bryceehill/EE_DEV_Board_2023/README.md

# EE_DEV_Board_2023
Files and Documentation for the Montana Tech EE Development Board
