bryceehill/EE_DEV_Board_2023/LayoutScrambled.PNG

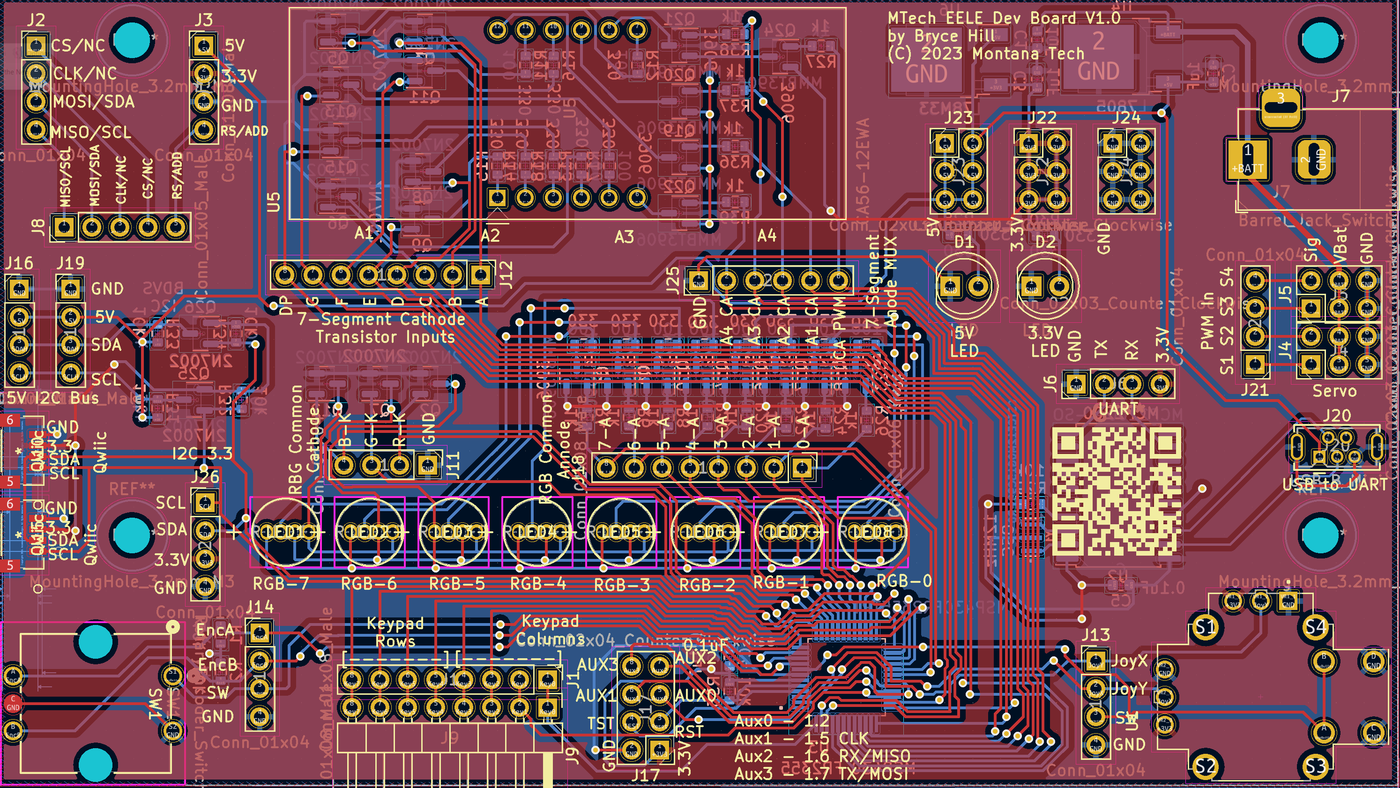
LayoutScrambled.PNG
