bryceehill/EE_DEV_Board_2023/LeftMCU.PNG

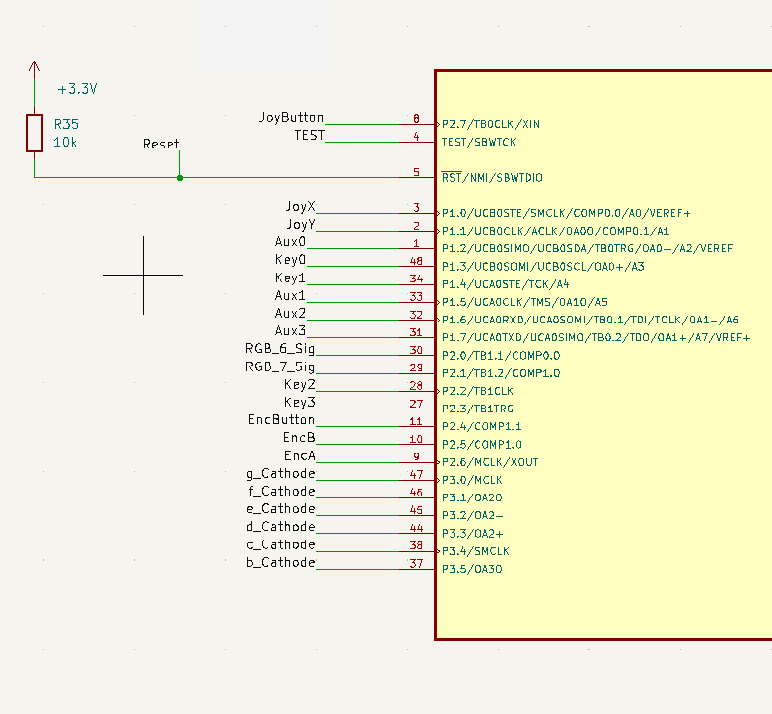
LeftMCU.PNG
