bryceehill/EE_DEV_Board_2023/RightMCU.PNG

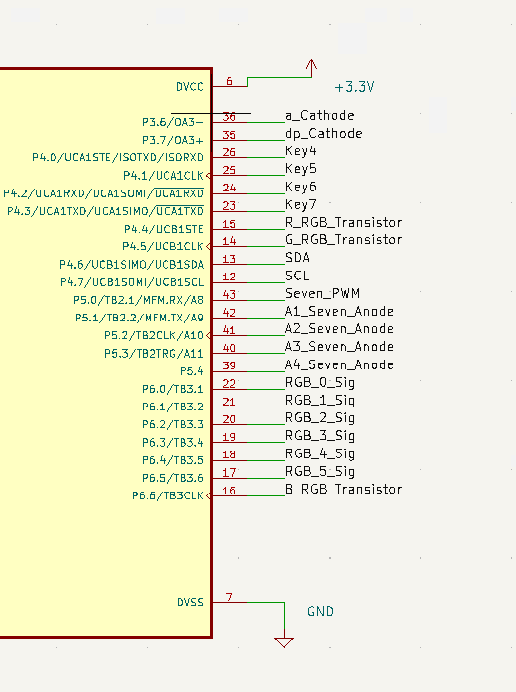
RightMCU.PNG
