bryceehill/EE_DEV_Board_2023/Schem_Dev2p0_Frame_2.PNG

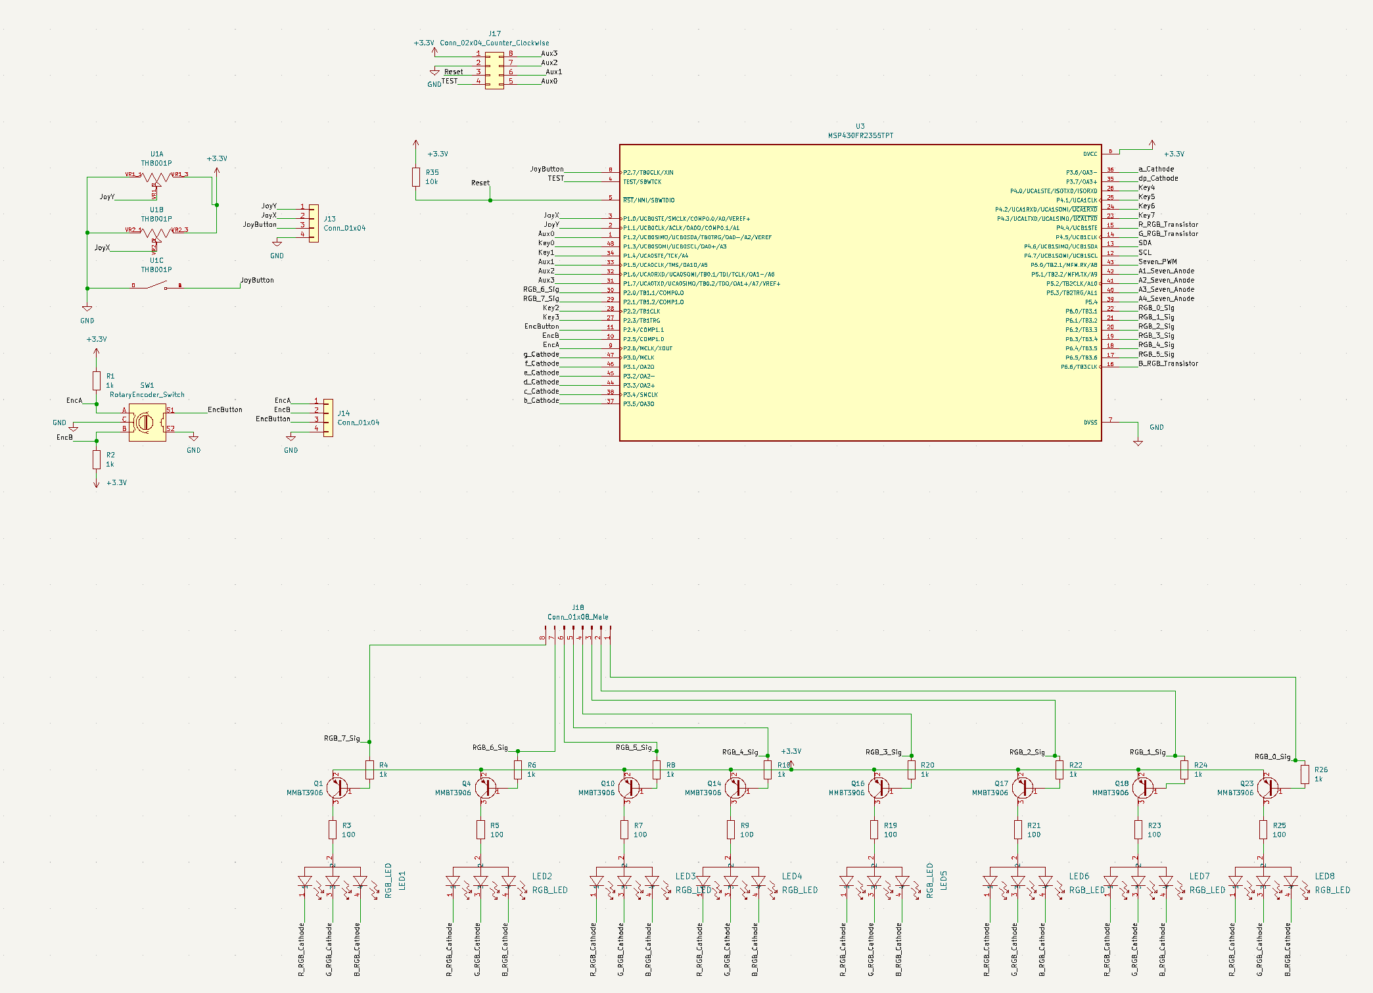
Schem_Dev2p0_Frame_2.PNG
