bryceehill/EE_DEV_Board_2023/DevBoard2.0.pdf

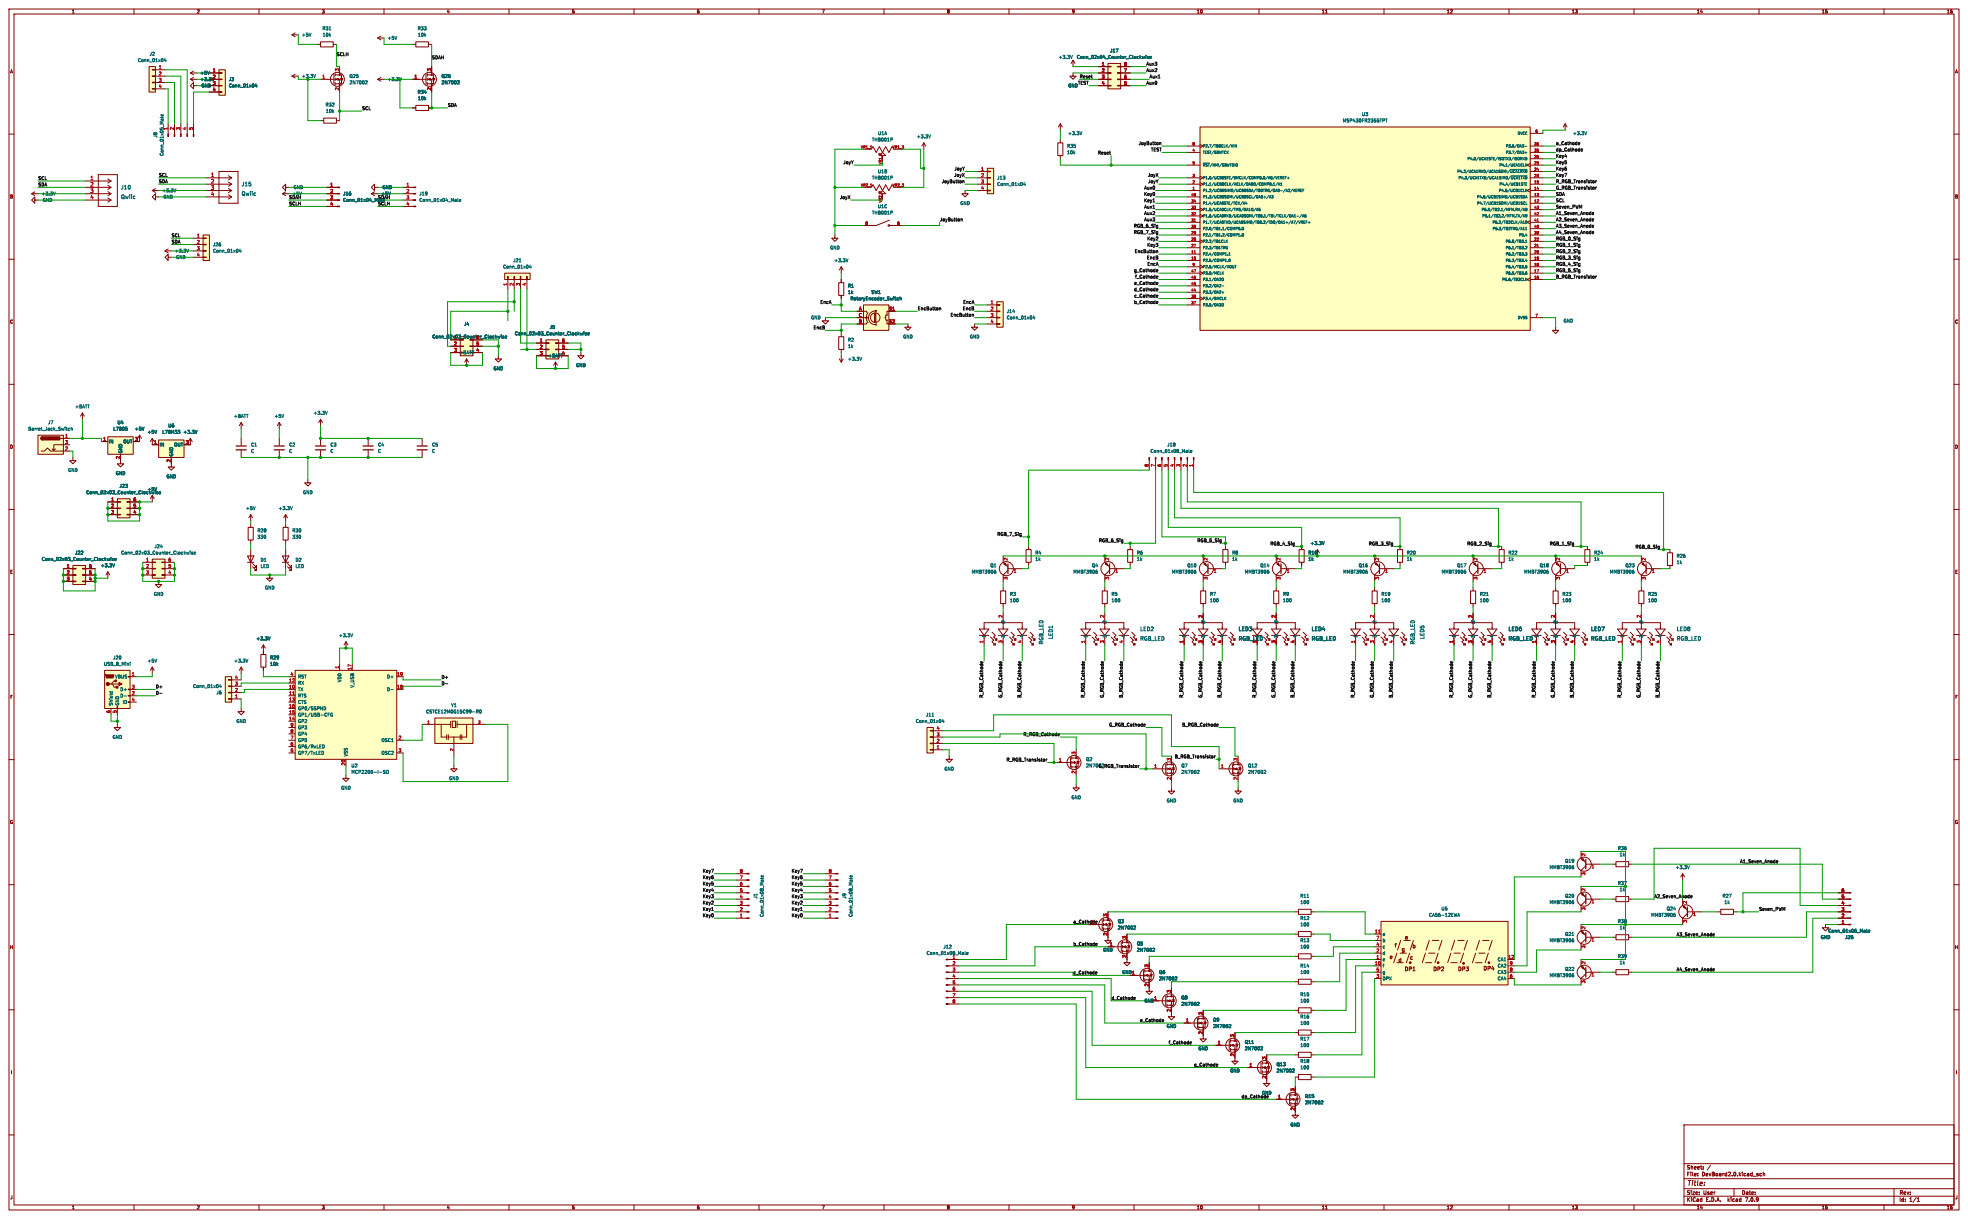
[picture p11: page 1]

1 TX 10 RTS 11 RX 12 CTS 13 GP2 14 GP1/USB-CFG 15 GP0/SSPND 16 V_USB 17 D- 18 D+ 19 OSC1 2 VSS 20 OSC2 3 RST 4 GP7/TxLED 5 GP6/RxLED 6 GP5 7 GP4 8 GP3 9 U2 MCP2200-I-SO
