bryceehill/EE_DEV_Board_2023/DevBoard2.0/DevBoard2.0.kicad_pcb

## KiCad design DevBoard2.0/DevBoard2.0.kicad_pcb (2023-08-30)

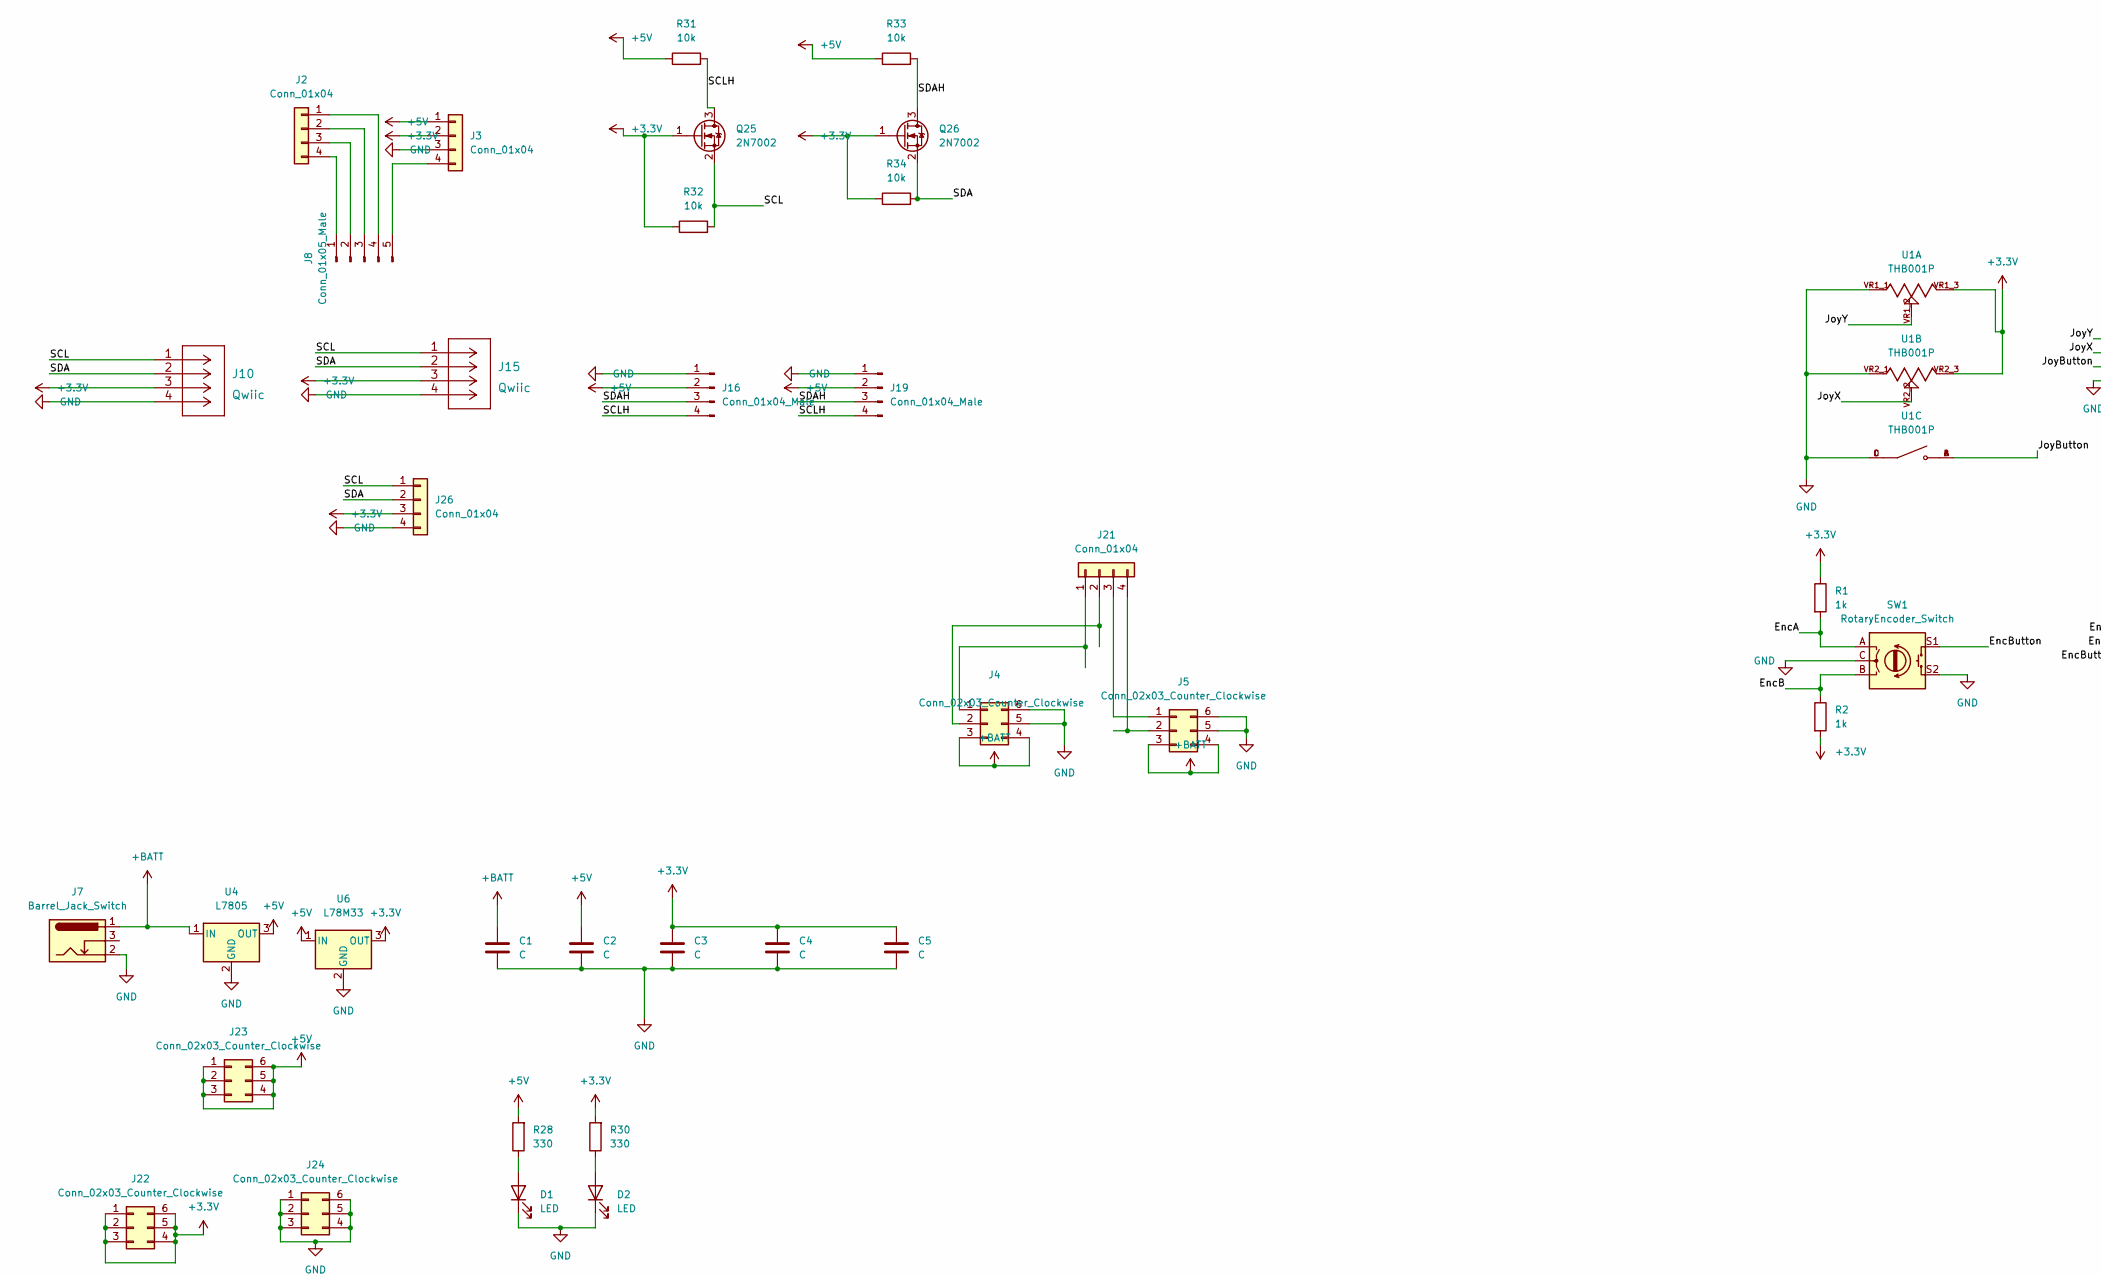
[picture p12: schematic DevBoard2.0.kicad_sch, part in row 1, column 1]

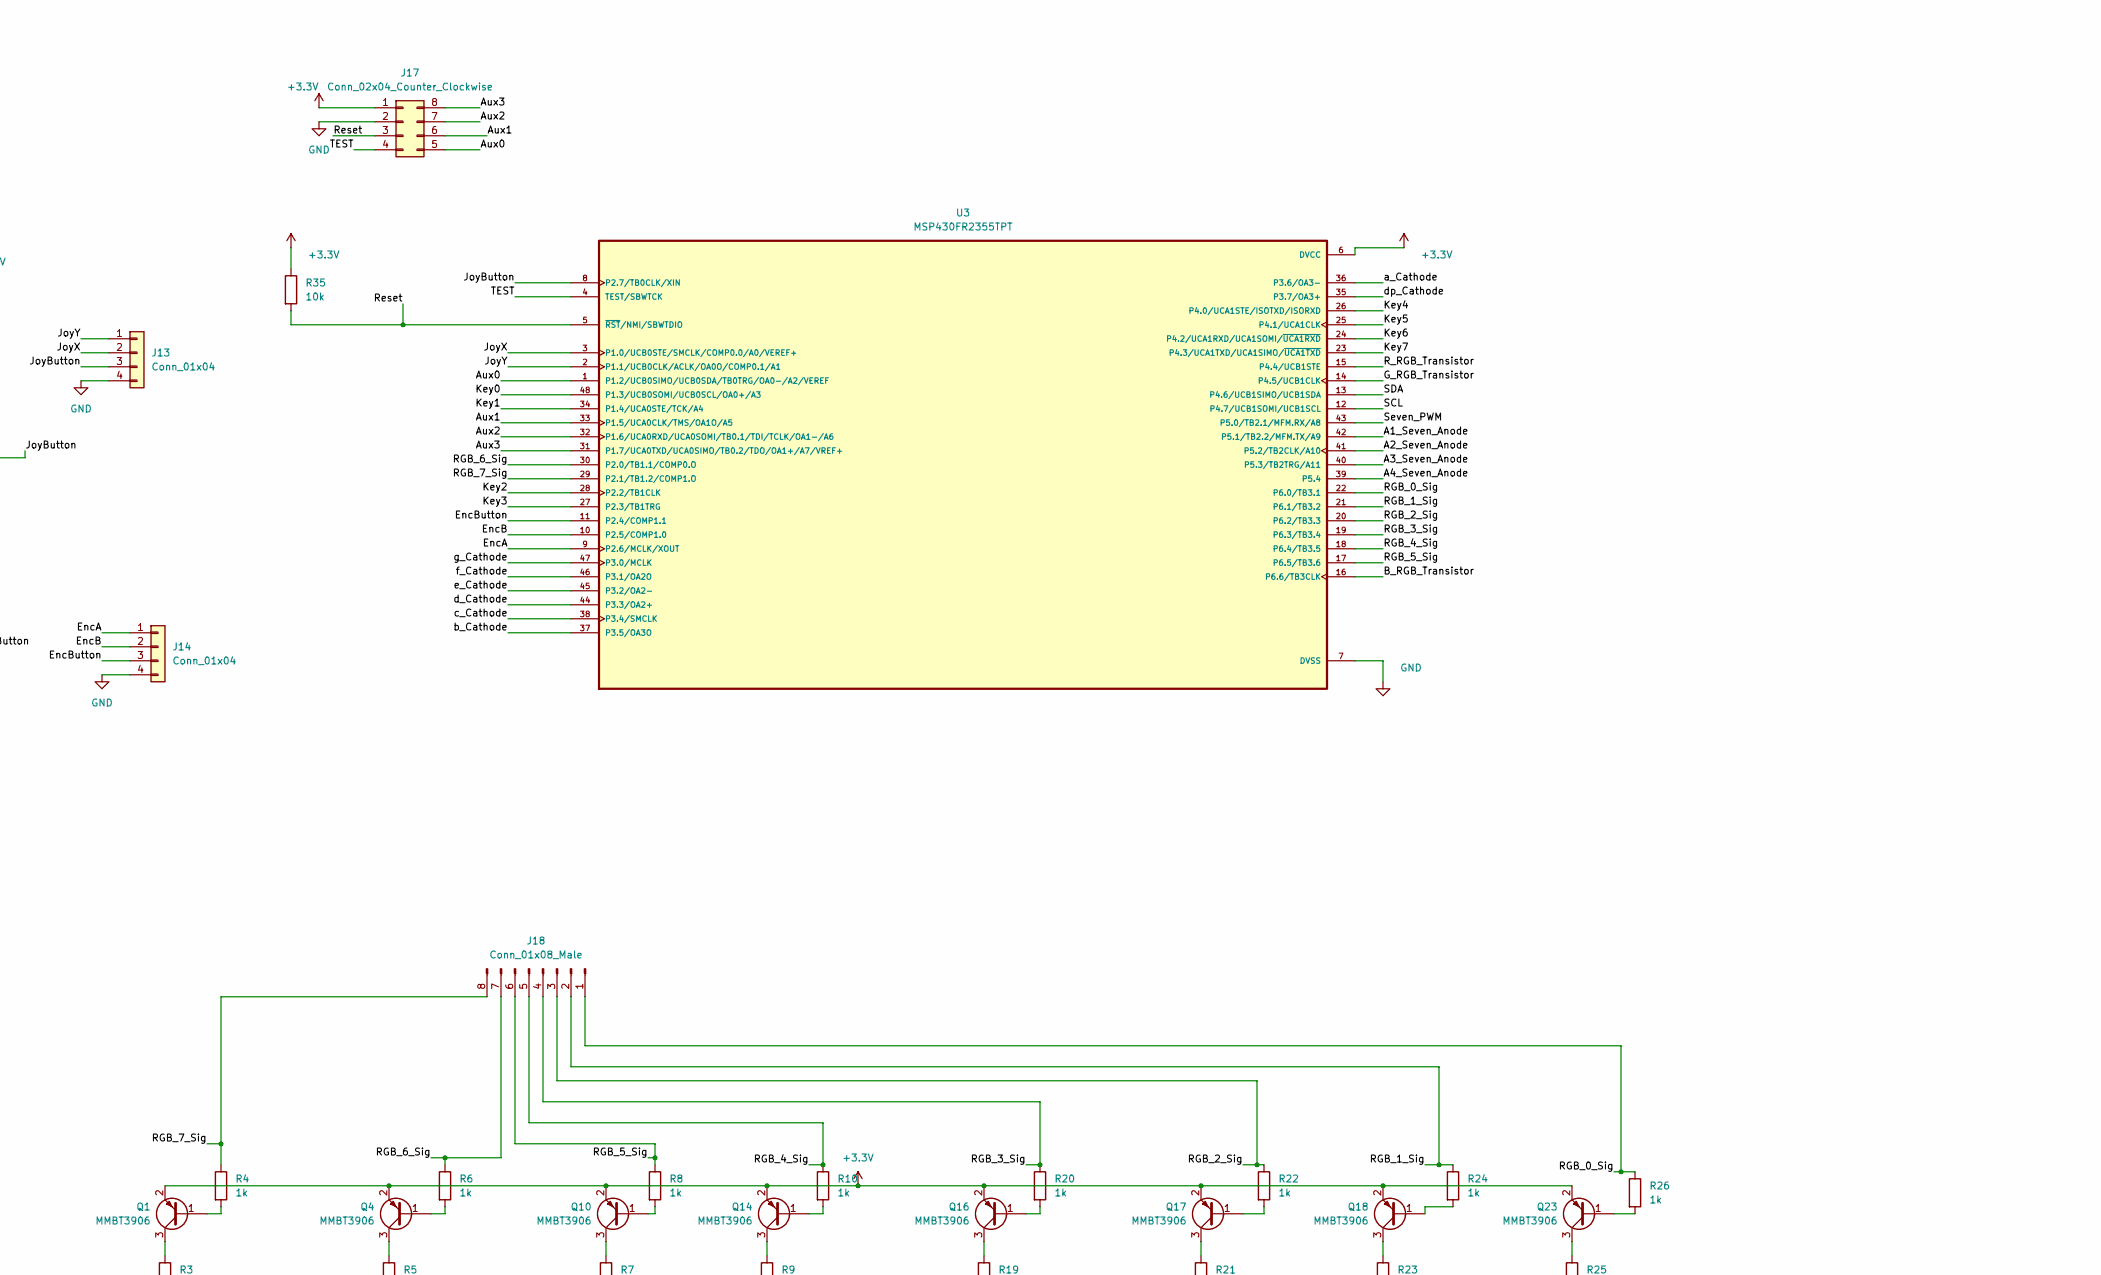
[picture p13: schematic DevBoard2.0.kicad_sch, part in row 1, column 2]

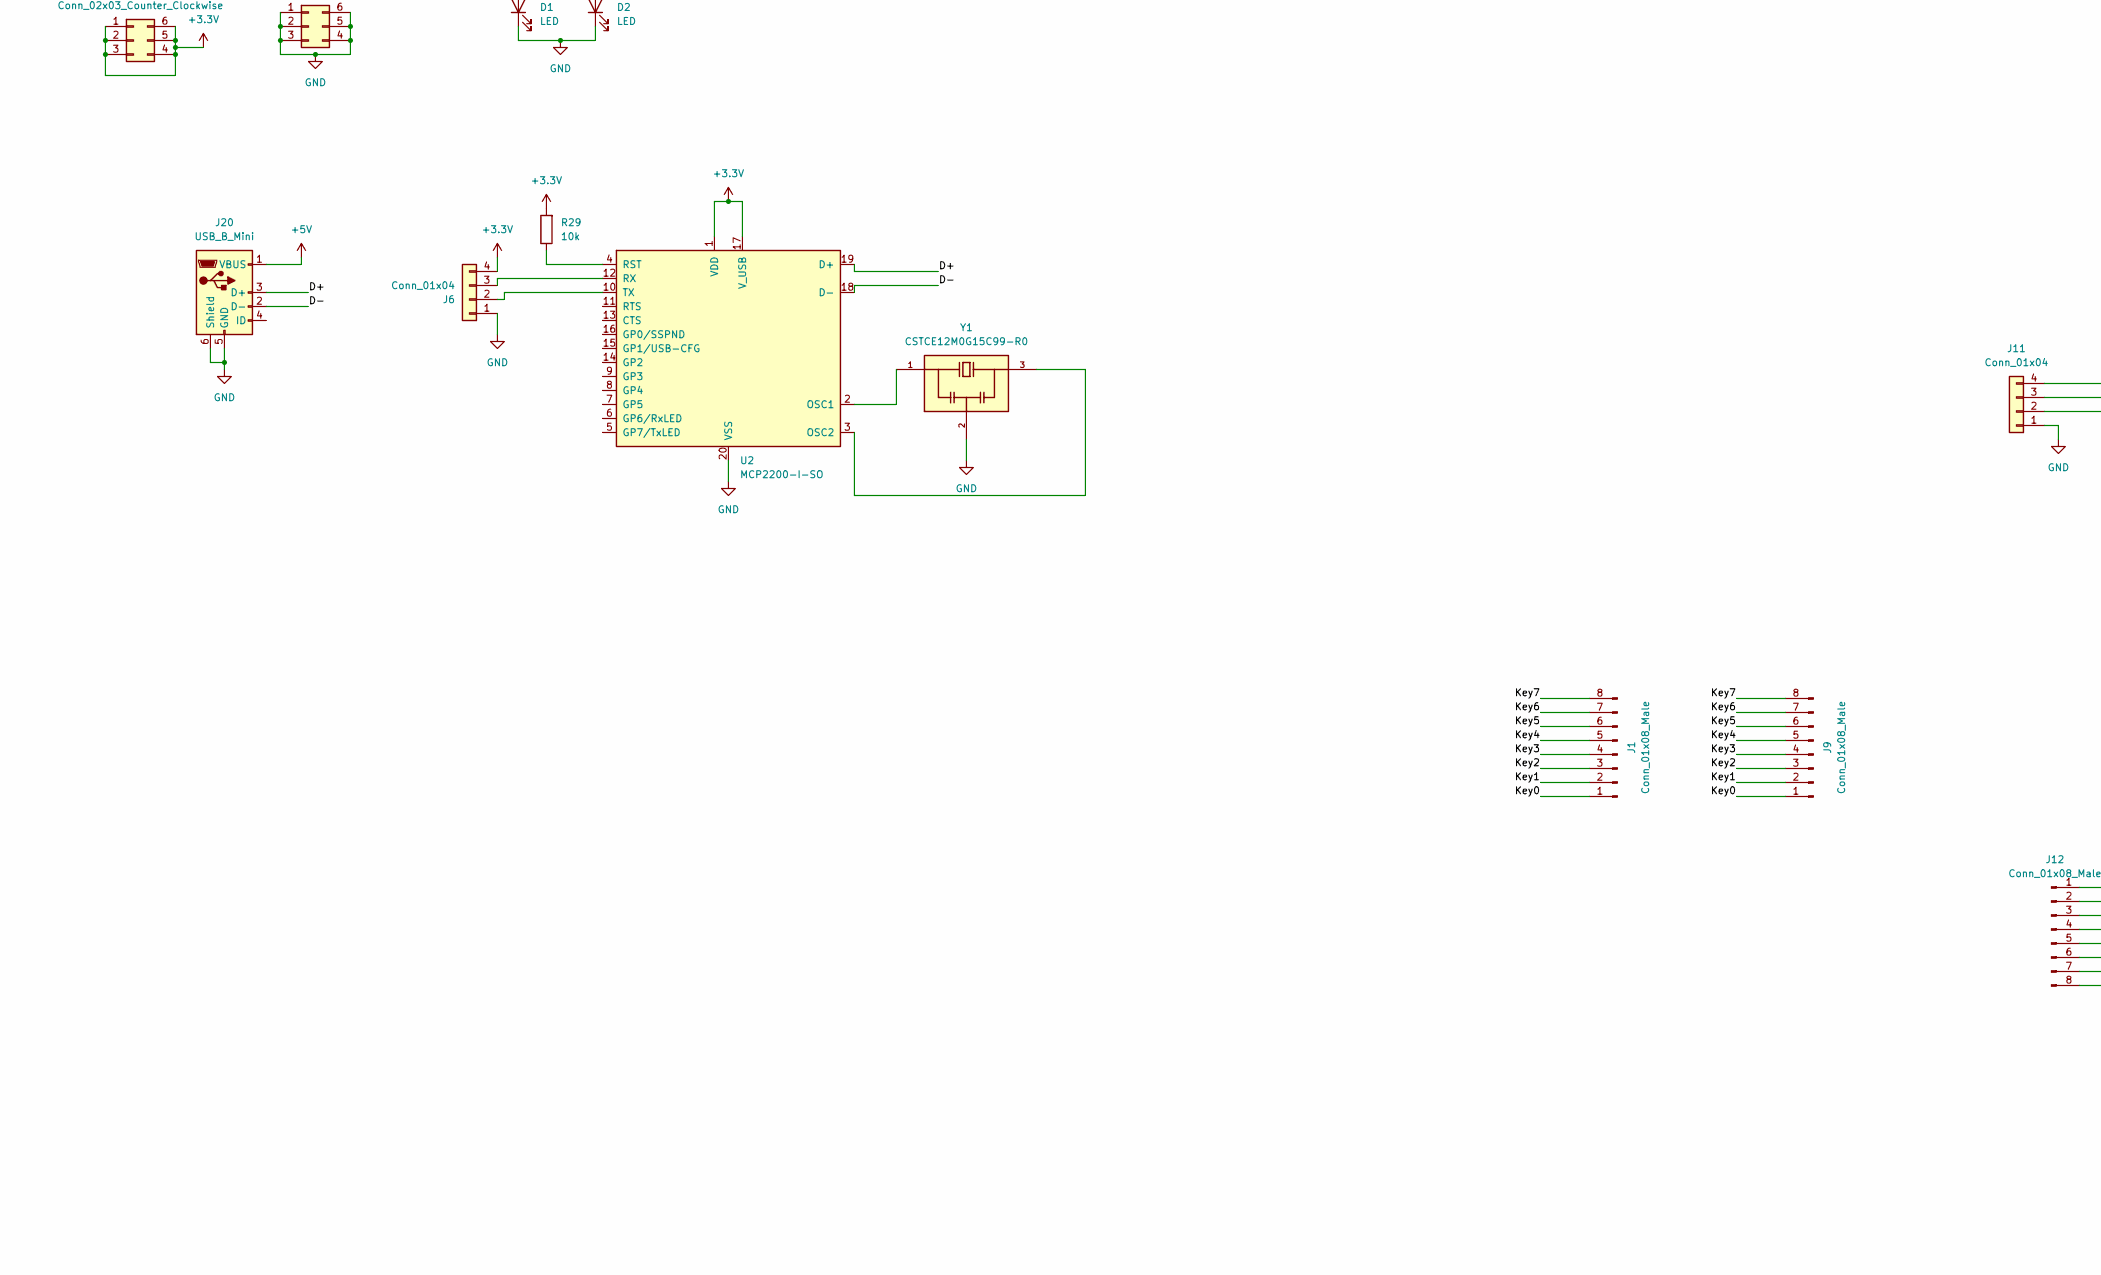
[picture p14: schematic DevBoard2.0.kicad_sch, part in row 2, column 1]

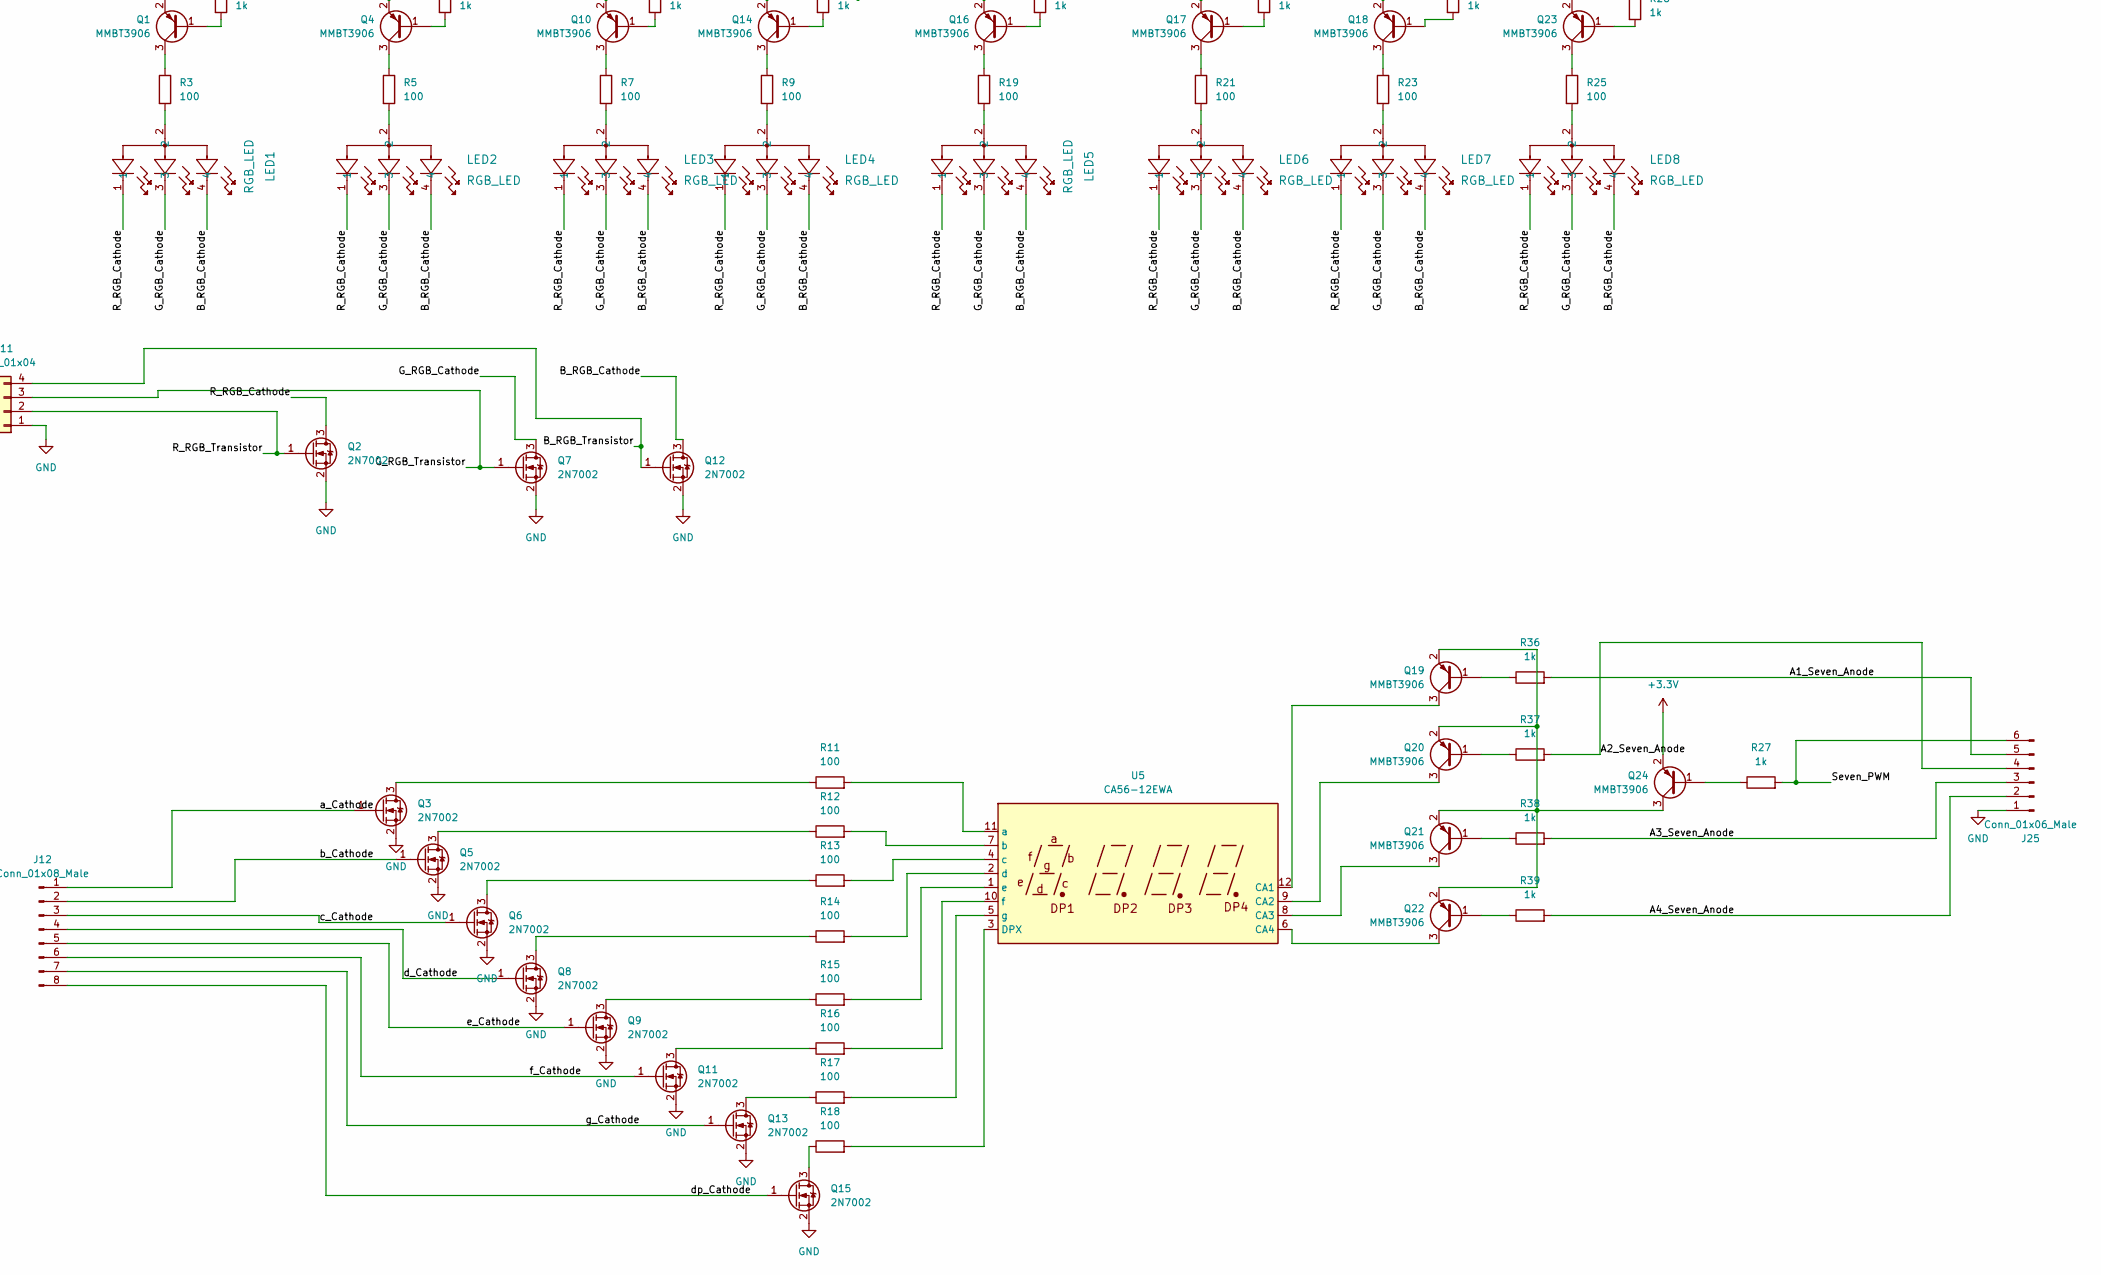
[picture p15: schematic DevBoard2.0.kicad_sch, part in row 2, column 2]

Parts:
C1, C2, C3, C4, C5: C; C_0603_1608Metric
D1, D2: LED; LED_D5.0mm_FlatTop
J1, J12, J18: Conn_01x08_Male; PinHeader_1x08_P2.54mm_Vertical
J2, J3, J6, J11, J13, J14, J21, J26: Conn_01x04; PinHeader_1x04_P2.54mm_Vertical
J4, J5, J22, J23, J24: Conn_02x03_Counter_Clockwise; PinHeader_2x03_P2.54mm_Vertical
J7: Barrel_Jack_Switch; BarrelJack_Horizontal
J8: Conn_01x05_Male; PinHeader_1x05_P2.54mm_Vertical
J9: Conn_01x08_Male; PinHeader_1x08_P2.54mm_Horizontal
J10, J15: Qwiic; PRT-16766
J16, J19: Conn_01x04_Male; PinHeader_1x04_P2.54mm_Vertical
J17: Conn_02x04_Counter_Clockwise; PinHeader_2x04_P2.54mm_Vertical
J20: USB_B_Mini; USB_Mini-B_Tensility_54-00023_Vertical
J25: Conn_01x06_Male; PinHeader_1x06_P2.54mm_Vertical
LED1, LED2, LED3, LED4, LED5, LED6, LED7, LED8: RGB_LED; LED_WP154A4SEJ3VBDZGC&slash_CA_KNB
Q1, Q4, Q10, Q14, Q16, Q17, Q18, Q19, Q20, Q21, Q22, Q23, Q24: MMBT3906; SOT-23
Q2, Q3, Q5, Q6, Q7, Q8, Q9, Q11, Q12, Q13, Q15, Q25, Q26: 2N7002; SOT-23
R1, R2, R4, R6, R8, R10, R20, R22, R24, R26, R27, R36, R37, R38, R39: 1k; R_0603_1608Metric
R3, R5, R7, R9, R11, R12, R13, R14, R15, R16, R17, R18, R19, R21, R23, R25: 100; R_0603_1608Metric
R28, R30: 330; R_0603_1608Metric
R29, R31, R32, R33, R34, R35: 10k; R_0603_1608Metric
SW1: RotaryEncoder_Switch; PEC12R-4x15F-Sxxxx_BRN
U1: THB001P; CNK_THB001P; PARTREV 27 Jan 22
U2: MCP2200-I-SO; SOIC-20W_7.5x12.8mm_P1.27mm
U3: MSP430FR2355TPT; QFP50P900X900X160-48N
U4: L7805; TO-252-2
U5: CA56-12EWA
U6: L78M33; TO-252-2
Y1: CSTCE12M0G15C99-R0; OSC_CSTCE12M0G15C99-R0; PARTREV May 7, 2019

Connections:
+3V3: C3.1, C4.1, C5.1, J3.2, J6.4, J10.3, J15.3, J17.1, J22.1, J22.2, J22.3, J22.4, J22.5, J22.6, J26.3, Q1.2 (E), Q4.2 (E), Q10.2 (E), Q14.2 (E), Q16.2 (E), Q17.2 (E), Q18.2 (E), Q23.2 (E), Q24.2 (E), Q25.1 (G), Q26.1 (G), R1.1, R2.2, R29.2, R30.2, R32.1, R34.1, R35.1, U1.VR1_3, U1.VR2_3, U2.1 (VDD), U2.17 (V_USB), U3.6 (DVCC), U6.3 (OUT)
+5V: C2.1, J3.1, J16.2, J19.2, J20.1 (VBUS), J23.1, J23.2, J23.3, J23.4, J23.5, J23.6, R28.2, R31.1, R33.1, U4.3 (OUT), U6.1 (IN)
+BATT: C1.1, J4.3, J4.4, J5.3, J5.4, J7.1, U4.1 (IN)
/A1_Seven_Anode: J25.5, R36.2, U3.42 (P5.1/TB2.2/MFM.TX/A9)
/A2_Seven_Anode: J25.4, R37.2, U3.41 (P5.2/TB2CLK/A10)
/A3_Seven_Anode: J25.3, R38.2, U3.40 (P5.3/TB2TRG/A11)
/A4_Seven_Anode: J25.2, R39.2, U3.39 (P5.4)
/Aux0: J17.5, U3.1 (P1.2/UCB0SIMO/UCB0SDA/TB0TRG/OA0-/A2/VE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)
/Aux1: J17.6, U3.33 (P1.5/UCA0CLK/TMS/OA1O/A5)
/Aux2: J17.7, U3.32 (P1.6/UCA0RXD/UCA0SOMI/TB0.1/TDI/TCLK/OA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)
/Aux3: J17.8, U3.31 (P1.7/UCA0TXD/UCA0SIMO/TB0.2/TDO/OA1+/A7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)
/B_RGB_Cathode: LED1.4, LED2.4, LED3.4, LED4.4, LED5.4, LED6.4, LED7.4, LED8.4, Q12.3 (D)
/B_RGB_Transistor: J11.4, Q12.1 (G), U3.16 (P6.6/TB3CLK)
/D+: J20.3 (D+), U2.19 (D+)
/D-: J20.2 (D-), U2.18 (D-)
/EncA: J14.1, R1.2, SW1.A, U3.9 (P2.6/MCLK/XOUT)
/EncB: J14.2, R2.1, SW1.B, U3.10 (P2.5/COMP1.0)
/EncButton: J14.3, SW1.S1, U3.11 (P2.4/COMP1.1)
/G_RGB_Cathode: LED1.3, LED2.3, LED3.3, LED4.3, LED5.3, LED6.3, LED7.3, LED8.3, Q7.3 (D)
/G_RGB_Transistor: J11.3, Q7.1 (G), U3.14 (P4.5/UCB1CLK)
/JoyButton: J13.3, U1.A, U1.B, U3.8 (P2.7/TB0CLK/XIN)
/JoyX: J13.2, U1.VR2_2, U3.3 (P1.0/UCB0STE/SMCLK/COMP0.0/A0/VEREF+)
/JoyY: J13.1, U1.VR1_2, U3.2 (P1.1/UCB0CLK/ACLK/OA0O/COMP0.1/A1)
/Key0: J1.1, J9.1, U3.48 (P1.3/UCB0SOMI/UCB0SCL/OA0+/A3)
/Key1: J1.2, J9.2, U3.34 (P1.4/UCA0STE/TCK/A4)
/Key2: J1.3, J9.3, U3.28 (P2.2/TB1CLK)
/Key3: J1.4, J9.4, U3.27 (P2.3/TB1TRG)
/Key4: J1.5, J9.5, U3.26 (P4.0/UCA1STE/ISOTXD/ISORXD)
/Key5: J1.6, J9.6, U3.25 (P4.1/UCA1CLK)
/Key6: J1.7, J9.7, U3.24 (P4.2/UCA1RXD/UCA1SOMI/~UCA1RXD)
/Key7: J1.8, J9.8, U3.23 (P4.3/UCA1TXD/UCA1SIMO/~UCA1TXD)
/RGB_0_Sig: J18.1, R26.1, U3.22 (P6.0/TB3.1)
/RGB_1_Sig: J18.2, R24.1, U3.21 (P6.1/TB3.2)
/RGB_2_Sig: J18.3, R22.1, U3.20 (P6.2/TB3.3)
/RGB_3_Sig: J18.4, R20.1, U3.19 (P6.3/TB3.4)
/RGB_4_Sig: J18.5, R10.1, U3.18 (P6.4/TB3.5)
/RGB_5_Sig: J18.6, R8.1, U3.17 (P6.5/TB3.6)
/RGB_6_Sig: J18.7, R6.1, U3.30 (P2.0/TB1.1/COMP0.O)
/RGB_7_Sig: J18.8, R4.1, U3.29 (P2.1/TB1.2/COMP1.O)
/R_RGB_Cathode: LED1.1, LED2.1, LED3.1, LED4.1, LED5.1, LED6.1, LED7.1, LED8.1, Q2.3 (D)
/R_RGB_Transistor: J11.2, Q2.1 (G), U3.15 (P4.4/UCB1STE)
/Reset: J17.3, R35.2, U3.5 (~RST/NMI/SBWTDIO)
/SCL: J10.1, J15.1, J26.1, Q25.2 (S), R32.2, U3.12 (P4.7/UCB1SOMI/UCB1SCL)
/SCLH: J16.4, J19.4, Q25.3 (D), R31.2
/SDA: J10.2, J15.2, J26.2, Q26.2 (S), R34.2, U3.13 (P4.6/UCB1SIMO/UCB1SDA)
/SDAH: J16.3, J19.3, Q26.3 (D), R33.2
/Seven_PWM: J25.6, R27.2, U3.43 (P5.0/TB2.1/MFM.RX/A8)
/TEST: J17.4, U3.4 (TEST/SBWTCK)
/a_Cathode: J12.1, Q3.1 (G), U3.36 (P3.6/OA3-)
/b_Cathode: J12.2, Q5.1 (G), U3.37 (P3.5/OA3O)
/c_Cathode: J12.3, Q6.1 (G), U3.38 (P3.4/SMCLK)
/d_Cathode: J12.4, Q8.1 (G), U3.44 (P3.3/OA2+)
/dp_Cathode: J12.8, Q15.1 (G), U3.35 (P3.7/OA3+)
/e_Cathode: J12.5, Q9.1 (G), U3.45 (P3.2/OA2-)
/f_Cathode: J12.6, Q11.1 (G), U3.46 (P3.1/OA2O)
/g_Cathode: J12.7, Q13.1 (G), U3.47 (P3.0/MCLK)
GND: C1.2, C2.2, C3.2, C4.2, C5.2, D1.1 (K), D2.1 (K), J3.3, J4.5, J4.6, J5.5, J5.6, J6.1, J7.2, J10.4, J11.1, J13.4, J14.4, J15.4, J16.1, J17.2, J19.1, J20.5 (GND), J20.6 (Shield), J24.1, J24.2, J24.3, J24.4, J24.5, J24.6, J25.1, J26.4, Q2.2 (S), Q3.2 (S), Q5.2 (S), Q6.2 (S), Q7.2 (S), Q8.2 (S), Q9.2 (S), Q11.2 (S), Q12.2 (S), Q13.2 (S), Q15.2 (S), SW1.C, SW1.S2, U1.C, U1.D, U1.VR1_1, U1.VR2_1, U2.20 (VSS), U3.7 (DVSS), U4.2 (GND), U6.2 (GND), Y1.2
unnamed: D1.2 (A), R28.1
unnamed: D2.2 (A), R30.1
unnamed: J3.4, J8.5
unnamed: J4.2, J21.2
unnamed: J2.4, J8.1
unnamed: J2.3, J8.2
unnamed: J2.2, J8.3
unnamed: J2.1, J8.4
unnamed: J4.1, J21.1
unnamed: J5.1, J21.3
unnamed: J5.2, J21.4
unnamed: LED1.2, R3.2
unnamed: LED2.2, R5.2
unnamed: LED3.2, R7.2
unnamed: LED4.2, R9.2
unnamed: LED5.2, R19.2
unnamed: LED6.2, R21.2
unnamed: LED7.2, R23.2
unnamed: LED8.2, R25.2
unnamed: Q1.1 (B), R4.2
unnamed: Q1.3 (C), R3.1
unnamed: Q3.3 (D), R11.1
unnamed: Q4.1 (B), R6.2
unnamed: Q4.3 (C), R5.1
unnamed: Q5.3 (D), R12.1
unnamed: Q6.3 (D), R13.1
unnamed: Q8.3 (D), R14.1
unnamed: Q9.3 (D), R15.1
unnamed: Q10.1 (B), R8.2
unnamed: Q10.3 (C), R7.1
unnamed: Q11.3 (D), R16.1
unnamed: Q13.3 (D), R17.1
unnamed: Q14.1 (B), R10.2
unnamed: Q14.3 (C), R9.1
unnamed: Q15.3 (D), R18.1
unnamed: Q16.1 (B), R20.2
unnamed: Q16.3 (C), R19.1
unnamed: Q17.1 (B), R22.2
unnamed: Q17.3 (C), R21.1
unnamed: Q18.1 (B), R24.2
unnamed: Q18.3 (C), R23.1
unnamed: Q19.1 (B), R36.1
unnamed: Q19.2 (E), Q20.2 (E), Q21.2 (E), Q22.2 (E), Q24.3 (C)
unnamed: Q20.1 (B), R37.1
unnamed: Q21.1 (B), R38.1
unnamed: Q22.1 (B), R39.1
unnamed: Q23.1 (B), R26.2
unnamed: Q23.3 (C), R25.1
unnamed: Q24.1 (B), R27.1
unnamed: U2.2 (OSC1), Y1.1
unnamed: U2.3 (OSC2), Y1.3
unnamed: R29.1, U2.4 (RST)
unnamed: J6.2, U2.10 (TX)
unnamed: J6.3, U2.12 (RX)
unnamed: R15.2, U5.1 (e)
unnamed: R14.2, U5.2 (d)
unnamed: R18.2, U5.3 (DPX)
unnamed: R13.2, U5.4 (c)
unnamed: R17.2, U5.5 (g)
unnamed: Q22.3 (C), U5.6 (CA4)
unnamed: R12.2, U5.7 (b)
unnamed: Q21.3 (C), U5.8 (CA3)
unnamed: Q20.3 (C), U5.9 (CA2)
unnamed: R16.2, U5.10 (f)
unnamed: R11.2, U5.11 (a)
unnamed: Q19.3 (C), U5.12 (CA1)

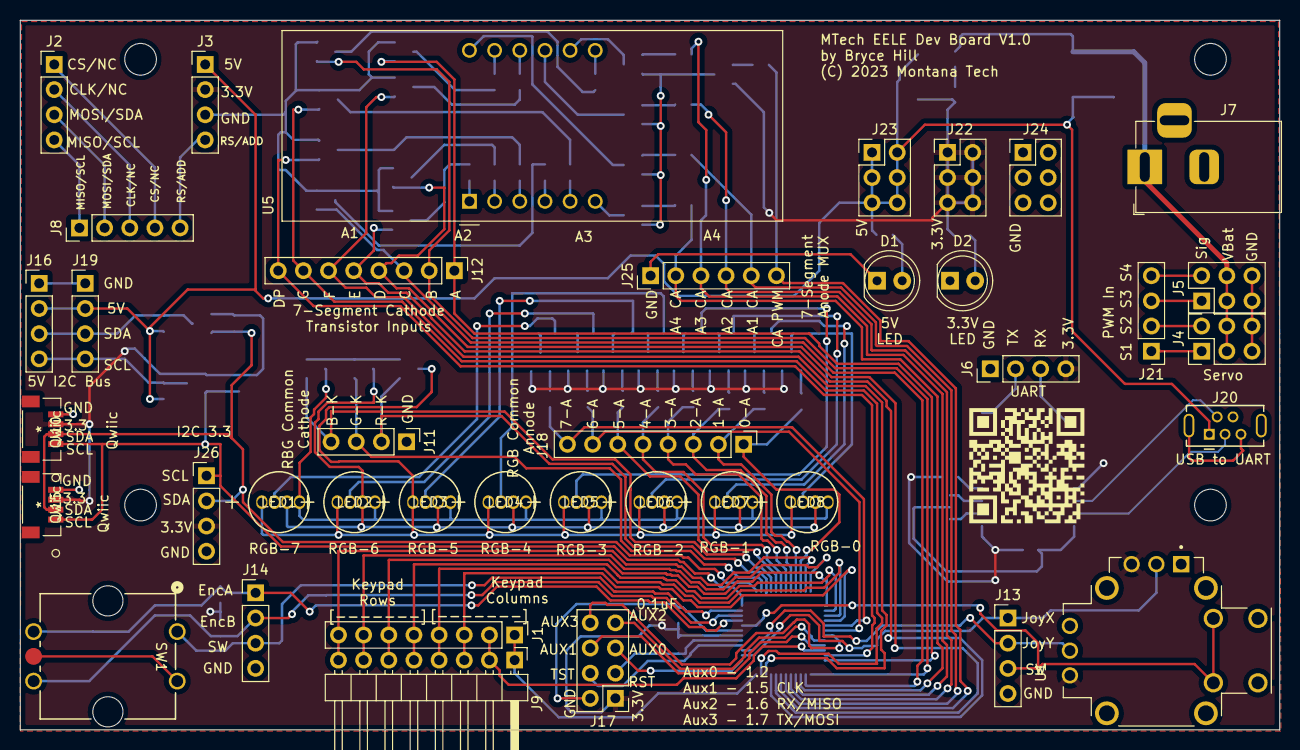
[picture p16: board DevBoard2.0.kicad_pcb from above]

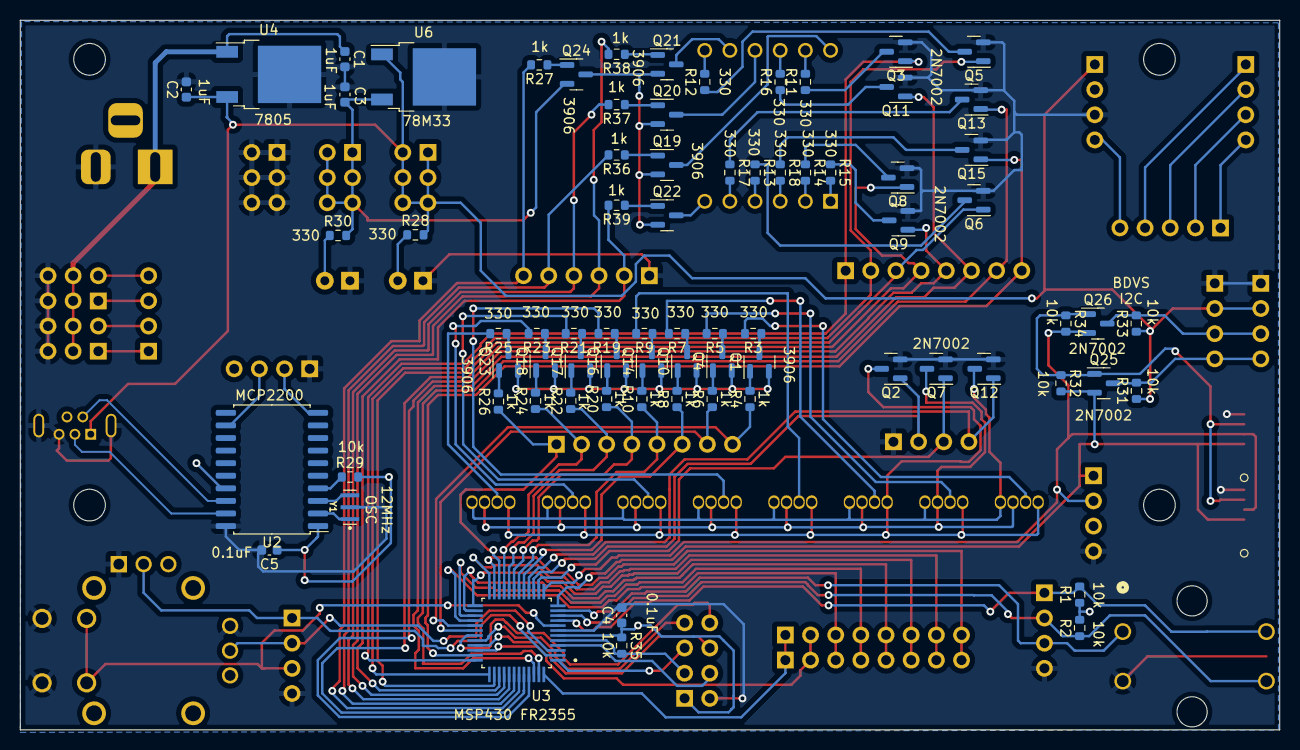
[picture p17: board DevBoard2.0.kicad_pcb from below]

Board: 2 copper layers, 127.1 x 71.6 mm, 114 parts (75 on the bottom side), 123 nets.
