bryceehill/EE_DEV_Board_2023/(commit log)

2023-08-30 Added Files for Dev2.0
    Initial images and KiCad files
    [DevBoard2.0-B_Cu.gbr, DevBoard2.0-B_Mask.gbr, DevBoard2.0-B_Paste.gbr, DevBoard2.0-B_Silkscreen.gbr, DevBoard2.0-Edge_Cuts.gbr, DevBoard2.0-F_Cu.gbr, DevBoard2.0-F_Mask.gbr, DevBoard2.0-F_Paste.gbr]
2024-01-05 Dev Board Documentation PDF and Word Doc
    Lots of information about how to use the dev board.
2024-01-05 Full Schematic added
