bryceehill/EE_DEV_Board_2023/(notices)

Notices in the files:
DevBoard2.0/DevBoard2.0.kicad_pcb:
(C) 2023 Montana Tech
parts and their libraries:
Copyright 2021 Accelerated Designs. All rights reserved.
